HoldenHalucha/office-hours-beacon/hardware/OHBeacon/S2B-ZR-SM4A-TF.step

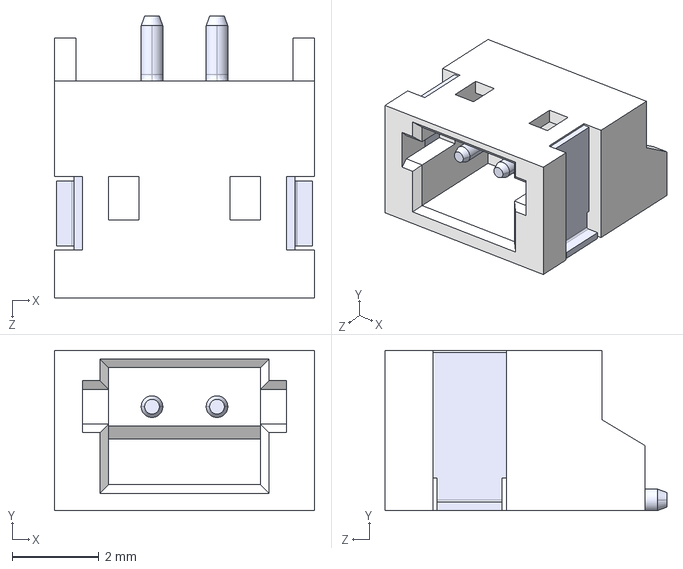
[picture p1: CAD file, 2025-11-12]
hardware/OHBeacon/S2B-ZR-SM4A-TF.step
6.00 x 3.70 x 6.50 mm
