HoldenHalucha/office-hours-beacon/power_usage_data/being_helped/power_profiler_screenshot.jpg

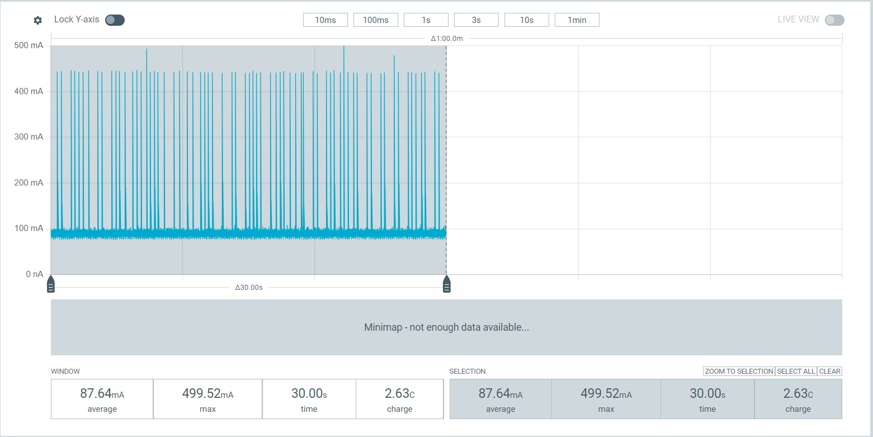
power_usage_data/being_helped/power_profiler_screenshot.jpg
