HoldenHalucha/office-hours-beacon/power_usage_data/not_on_queue/power_profiler_screenshot.jpg

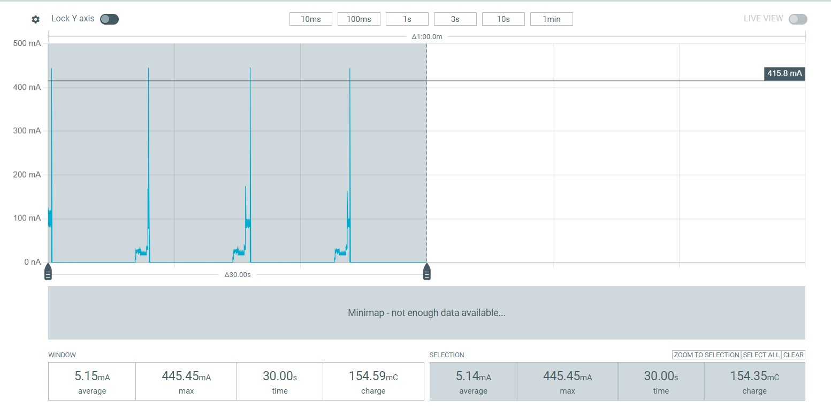
power_usage_data/not_on_queue/power_profiler_screenshot.jpg
