HoldenHalucha/office-hours-beacon/power_usage_data/pos1/power_profiler_screenshot.jpg

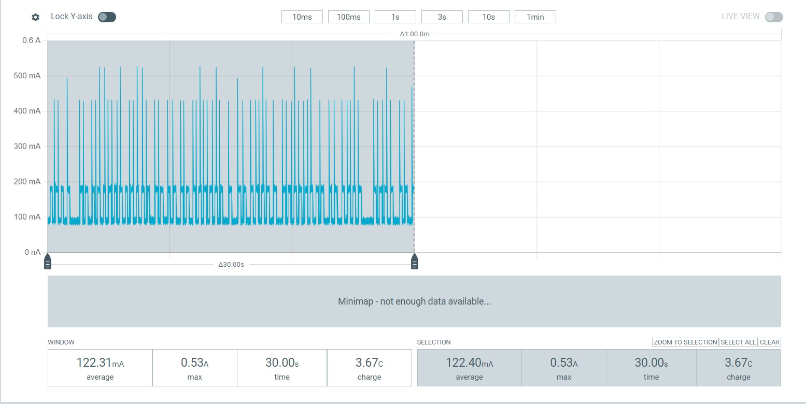
power_usage_data/pos1/power_profiler_screenshot.jpg
