HoldenHalucha/office-hours-beacon/(list of files, drawings)

Other design files:
PowerPCB.PrjPcb
PowerPCB.SchDoc
