HoldenHalucha/office-hours-beacon/hardware/OHBeacon/OHBeacon.kicad_pcb

## KiCad design hardware/OHBeacon/OHBeacon.kicad_pcb (2025-11-14)

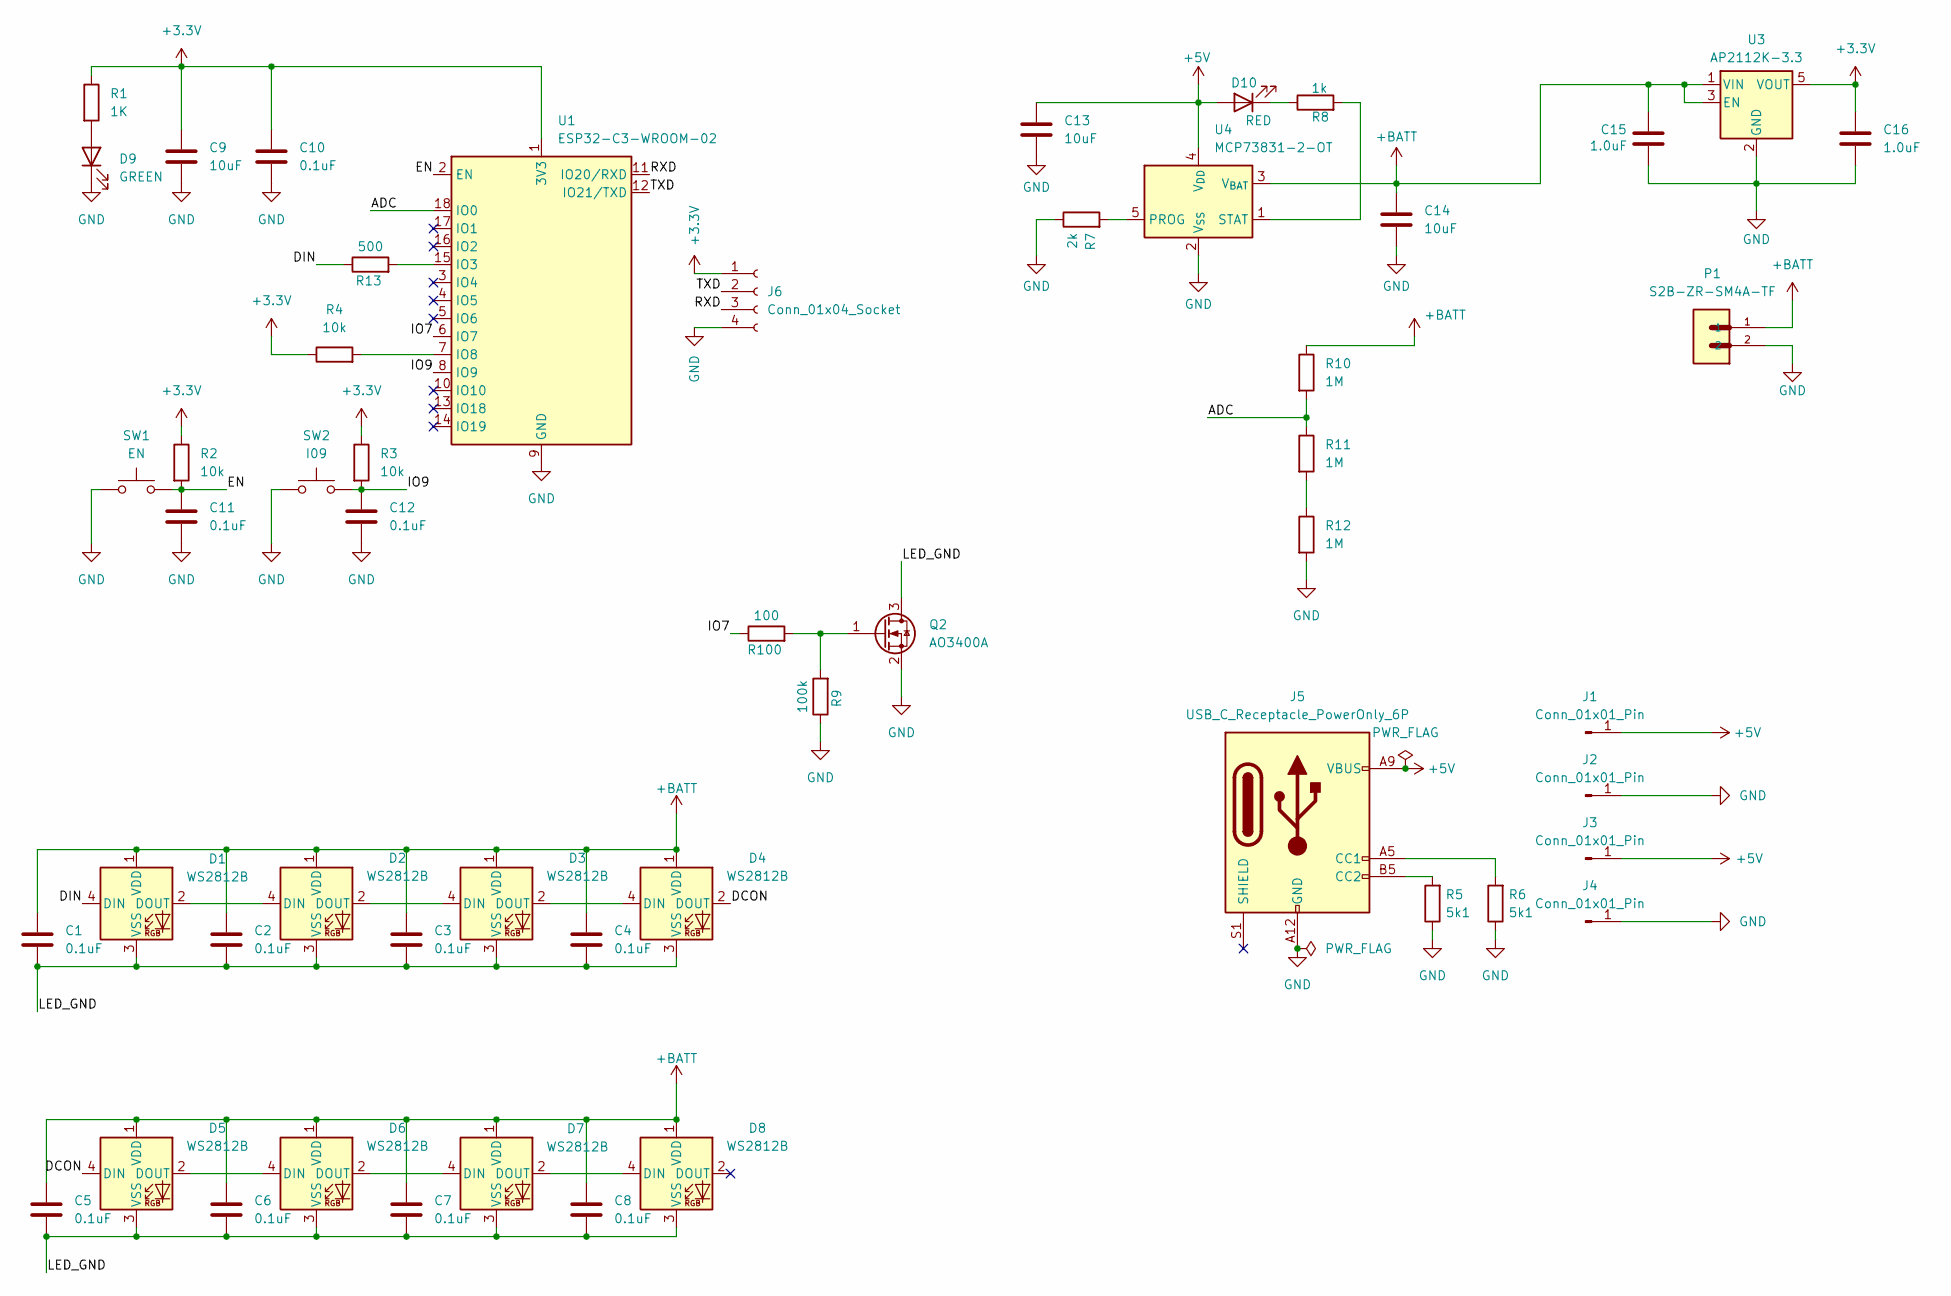
[picture p5: schematic OHBeacon.kicad_sch]

Parts:
C1, C2, C3, C4, C5, C6, C7, C8, C10, C11, C12: 0.1uF; C_0805_2012Metric_Pad1.18x1.45mm_HandSolder
C9, C13, C14: 10uF; C_0805_2012Metric_Pad1.18x1.45mm_HandSolder
C15, C16: 1.0uF; C_0805_2012Metric_Pad1.18x1.45mm_HandSolder
D1, D2, D3, D4, D5, D6, D7, D8: WS2812B; LED_WS2812B_PLCC4_5.0x5.0mm_P3.2mm
D9: GREEN; LED_0805_2012Metric_Pad1.15x1.40mm_HandSolder
D10: RED; LED_0805_2012Metric_Pad1.15x1.40mm_HandSolder
J1, J2, J3, J4: Conn_01x01_Pin; SolderWire-1sqmm_1x01_D1.4mm_OD3.9mm
J5: USB_C_Receptacle_PowerOnly_6P; USB_C_Receptacle_GCT_USB4135-GF-A_6P_TopMnt_Horizontal
J6: Conn_01x04_Socket; PinHeader_1x04_P2.54mm_Vertical
P1: S2B-ZR-SM4A-TF; JST_S2B-ZR-SM4A-TF
Q2: AO3400A; SOT-23
R1: 1K; R_0805_2012Metric_Pad1.20x1.40mm_HandSolder
R2, R3, R4: 10k; R_0805_2012Metric_Pad1.20x1.40mm_HandSolder
R5, R6: 5k1; R_0805_2012Metric_Pad1.20x1.40mm_HandSolder
R7: 2k; R_0805_2012Metric_Pad1.20x1.40mm_HandSolder
R8: 1k; R_0805_2012Metric_Pad1.20x1.40mm_HandSolder
R9: 100k; R_0805_2012Metric_Pad1.20x1.40mm_HandSolder
R10, R11, R12: 1M; R_0805_2012Metric_Pad1.20x1.40mm_HandSolder
R13: 500; R_0805_2012Metric_Pad1.20x1.40mm_HandSolder
R100: 100; R_0805_2012Metric_Pad1.20x1.40mm_HandSolder
SW1: EN; SW_PUSH_6mm
SW2: I09; SW_PUSH_6mm
U1: ESP32-C3-WROOM-02
U3: AP2112K-3.3; SOT-23-5
U4: MCP73831-2-OT; SOT-23-5

Connections:
+3.3V: C9.1, C10.1, C16.1, J6.1, R1.1, R2.1, R3.1, R4.1, U1.1 (3V3), U3.5 (VOUT)
+5V: C13.1, D10.2 (A), J1.1, J3.1, J5.A9 (VBUS), J5.B9 (VBUS), U4.4 (V_{DD})
+BATT: C1.1, C2.1, C3.1, C4.1, C5.1, C6.1, C7.1, C8.1, C14.1, C15.1, D1.1 (VDD), D2.1 (VDD), D3.1 (VDD), D4.1 (VDD), D5.1 (VDD), D6.1 (VDD), D7.1 (VDD), D8.1 (VDD), P1.1, R10.1, U3.1 (VIN), U3.3 (EN), U4.3 (V_{BAT})
/ADC: R10.2, R11.1, U1.18 (IO0)
/DCON: D4.2 (DOUT), D5.4 (DIN)
/DIN: D1.4 (DIN), R13.1
/EN: C11.1, R2.2, SW1.2, U1.2 (EN)
/IO7: R100.1, U1.6 (IO7)
/IO9: C12.1, R3.2, SW2.2, U1.8 (IO9)
/LED_GND: C1.2, C2.2, C3.2, C4.2, C5.2, C6.2, C7.2, C8.2, D1.3 (VSS), D2.3 (VSS), D3.3 (VSS), D4.3 (VSS), D5.3 (VSS), D6.3 (VSS), D7.3 (VSS), D8.3 (VSS), Q2.3 (D)
/RXD: J6.3, U1.11 (IO20/RXD)
/TXD: J6.2, U1.12 (IO21/TXD)
GND: C9.2, C10.2, C11.2, C12.2, C13.2, C14.2, C15.2, C16.2, D9.1 (K), J2.1, J4.1, J5.A12 (GND), J5.B12 (GND), J6.4, P1.2, Q2.2 (S), R5.1, R6.1, R7.1, R9.1, R12.2, SW1.1, SW2.1, U1.9 (GND), U1.19 (GND), U3.2 (GND), U4.2 (V_{SS})
unnamed: D1.2 (DOUT), D2.4 (DIN)
unnamed: D2.2 (DOUT), D3.4 (DIN)
unnamed: D3.2 (DOUT), D4.4 (DIN)
unnamed: D5.2 (DOUT), D6.4 (DIN)
unnamed: D6.2 (DOUT), D7.4 (DIN)
unnamed: D7.2 (DOUT), D8.4 (DIN)
unnamed: D9.2 (A), R1.2
unnamed: D10.1 (K), R8.1
unnamed: J5.A5 (CC1), R6.2
unnamed: J5.B5 (CC2), R5.2
unnamed: Q2.1 (G), R9.2, R100.2
unnamed: R11.2, R12.1
unnamed: R13.2, U1.15 (IO3)
unnamed: R4.2, U1.7 (IO8)
unnamed: R7.2, U4.5 (PROG)
unnamed: R8.2, U4.1 (STAT)

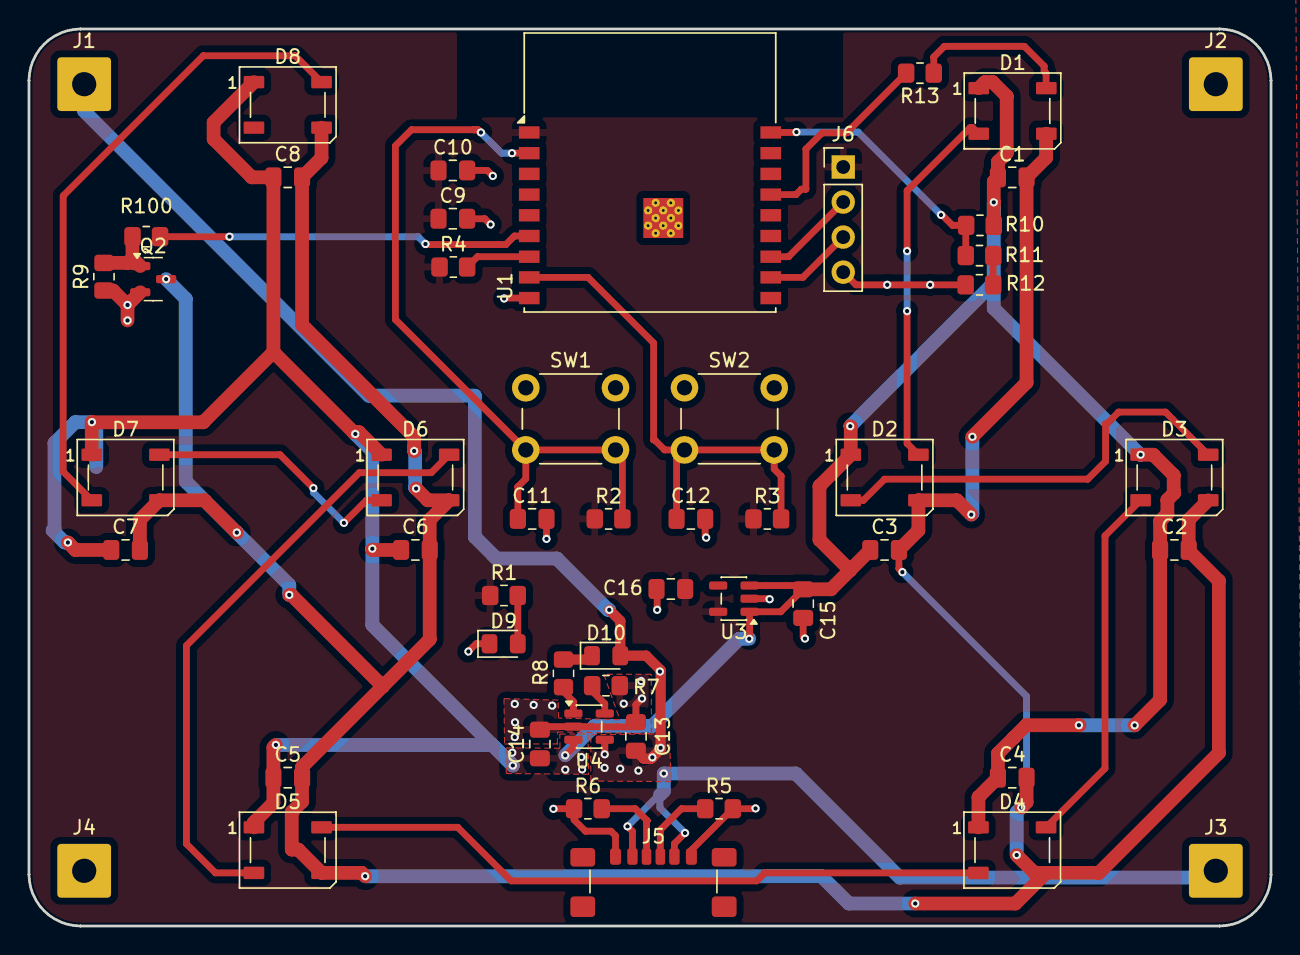
[picture p6: board OHBeacon.kicad_pcb from above]

Board: 2 copper layers, 90.0 x 65.0 mm, 53 parts (1 on the bottom side), 29 nets.
