HoldenHalucha/office-hours-beacon/hardware/raspberryPiHat/RaspberryPiHat.kicad_pcb

## KiCad design hardware/raspberryPiHat/RaspberryPiHat.kicad_pcb (2025-10-27)

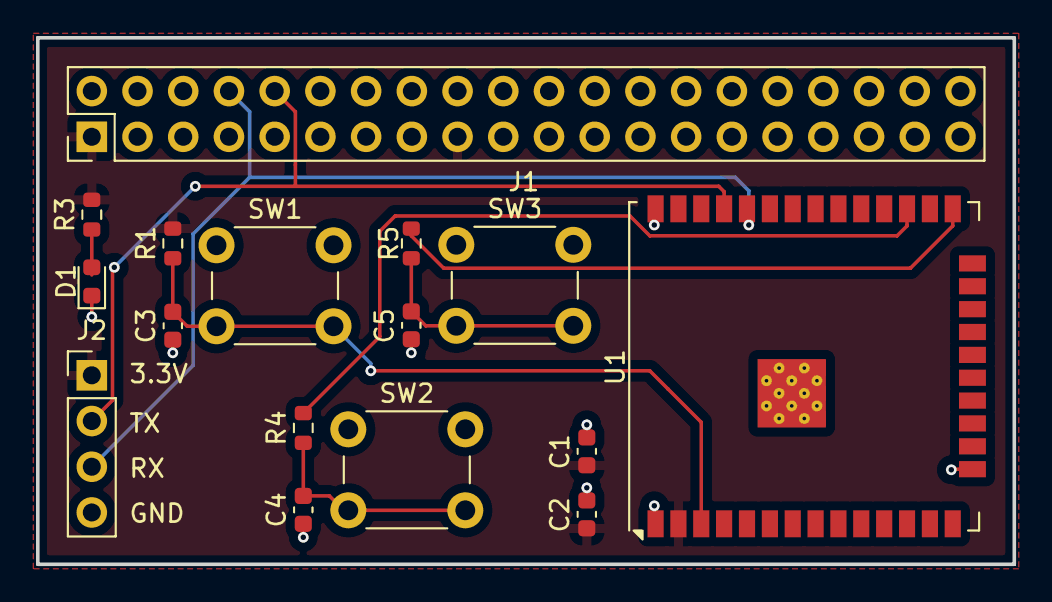
[picture p7: board RaspberryPiHat.kicad_pcb from above]

Board: 2 copper layers, 54.2 x 29.2 mm, 16 parts (0 on the bottom side), 10 nets.

Parts:
C1: 22uF; C_0603_1608Metric
C2, C3, C4, C5: 0.1uF; C_0603_1608Metric
D1: LED; LED_0603_1608Metric
J1: Raspberry_Pi_2_3; PinHeader_2x20_P2.54mm_Vertical
J2: Conn_01x04_Socket; PinHeader_1x04_P2.54mm_Vertical
R1, R4, R5: 10k; R_0603_1608Metric
R3: 150; R_0603_1608Metric
SW1, SW2, SW3: SW_Push; SW_PUSH_6mm
U1: ESP32-WROOM-32U

Connections:
+3.3V: C1.1, C2.1, J1.1 (3V3), J1.17 (3V3), J2.1, R1.1, R3.1, U1.2 (VDD)
/IO0: R5.1, U1.25 (IO0)
/MODE: R4.1, U1.27 (IO16)
/RXD0: J1.8 (GPIO14/TXD), J2.3, U1.34 (RXD0/IO3)
/TXD0: J1.10 (GPIO15/RXD), J2.2, U1.35 (TXD0/IO1)
GND: C1.2, C2.2, C3.2, C4.2, C5.2, D1.1 (K), J1.6 (GND), J1.9 (GND), J1.14 (GND), J1.20 (GND), J1.25 (GND), J1.30 (GND), J1.34 (GND), J1.39 (GND), J2.4, SW1.1, SW2.1, SW3.1, U1.1 (GND), U1.15 (GND), U1.38 (GND), U1.39 (GND)
unnamed: C4.1, R4.2, SW2.2
unnamed: C5.1, R5.2, SW3.2
unnamed: D1.2 (A), R3.2
unnamed: C3.1, R1.2, SW1.2, U1.3 (EN)
