HoldenHalucha/office-hours-beacon/queueFetcher/main.py

#!/usr/bin/env python3
"""
selenium_fetch.py
Use Selenium to sign into the site (interactive or automated),
export cookies, then fetch the JSON and save it.
"""

import os
import time
import json
from fetcher import Fetcher
import serial

OUT_DIR = "./outstanding_json"
BASE_STATION_ID = "A"


# Absolute path to cookies file
COOKIES_FILE = "/home/user473/Documents/project/office-hours-beacon/queueFetcher/oh_cookies.json"

os.makedirs(OUT_DIR, exist_ok=True)

# Configure the serial port and baud rate
ser = serial.Serial(
    port='/dev/serial0',  # or '/dev/ttyS0' depending on your Pi model and OS
    baudrate=9600,
    timeout=1
)



if __name__ == "__main__":

    fetcher_configs = {
        'max_course': 2,
        'course_polling_interval_seconds': 2,
        'course_thread_expiration_seconds': 10,
        'active_course_scan_interval_seconds': 5
    }

    fetcher = Fetcher(BASE_STATION_ID, COOKIES_FILE, configs=fetcher_configs)

    # Precomputed valid course IDs. This list would change if new courses are added to OH queue.
    valid_course_list = [808, 815, 816, 820, 823, 825, 826, 827, 829, 830, 833, 834, 839, 850, 856, 864, 866, 868, 869, 877, 878, 880, 881, 882, 883, 884, 887, 889, 890, 893, 894, 895, 896, 897, 898, 899, 900, 901, 902, 904, 905, 906, 907, 908, 909, 910, 911, 913, 916, 917, 918, 919]
    fetcher.valid_course_list = valid_course_list

    fetcher.start_course_thread_manager(verbose=True)

    try:
        while True:
            time.sleep(2)
            events = fetcher.get_serial_events()

            for event in events:
                message = f"S{event['beacon_id']}%{event['queue_position']}%{event['course_color']}Z"
                print(f"Sending serial message: {message}")
                ser.write(message.encode('ascii'))
                time.sleep(0.1)  # brief pause between messages
             

    except KeyboardInterrupt:
        print("Stopping fetcher...")
        fetcher.running = False
