HoldenHalucha/office-hours-beacon/(commit log)

2025-09-25 Added anither fetch function
    The added fetch_and_print_json() function continuously fetch and print JSON to console.
2025-10-02 raspberry pi hat pcb rev 1
    [RaspberryPiHat.kicad_pcb, RaspberryPiHat.kicad_sch]
2025-10-11 first commit for OH student beacon
    [LED_strip.kicad_sch, OHBeacon.kicad_pcb, OHBeacon.kicad_sch, power_input.kicad_sch, untitled.kicad_sch]
2025-10-11 oh student beacon pcb first commit
2025-10-22 Added "Fetch" class for better encapsulation; Added thread manager to Fetch class
2025-10-23 esp32c3 low power experimentation with ESP-IDF
2025-10-23 new sch
    [OHBeacon.kicad_pcb, OHBeacon.kicad_sch, power_input.kicad_sch]
2025-10-25 Some small changes to receiver code for power saving experimentation.
2025-10-26 prelim beacon pcb
    [OHBeacon.kicad_pcb, OHBeacon.kicad_sch]
2025-10-26 Changed some stuff in the schematic :)
    [OHBeacon.kicad_pcb, OHBeacon.kicad_sch]
2025-10-27 updated beacon
    [OHBeacon.kicad_pcb]
2025-10-27 updated rpi
    [RaspberryPiHat.kicad_pcb, RaspberryPiHat.kicad_sch]
2025-10-28 okay it's fine for prod ig
    [OHBeacon.kicad_pcb]
2025-10-28 production folders for both PCBs
    [bom.csv, designators.csv, positions.csv]
2025-10-28 Added course color and reworked some course thread interface
    [fetch_test.py, fetcher.py, selenium_fetch.py]
2025-11-03 quick fix for testing
    [esp32_receiver.c, esp32_transmitter.ino]
2025-11-04 fixed the mac address sending stuff
    [esp32_transmitter.ino]
2025-11-06 Reverted main to work with oh.eecs
    This commit makes main branch work with oh.eecs.
    Another branch, eecsoh, works with eecsoh.eecs.
    [fetch_test.py, fetcher.py]
2025-11-12 new oh beacon schematic and early routing
    [OHBeacon.kicad_pcb, OHBeacon.kicad_sch, S2B-ZR-SM4A-TF.step]
2025-11-12 new charging
    [OHBeacon.kicad_pcb, OHBeacon.kicad_sch]
2025-11-12 get james approval
    [OHBeacon.kicad_pcb, OHBeacon.kicad_sch]
2025-11-14 final pcb?
    [OHBeacon.kicad_pcb, OHBeacon.kicad_sch]
2025-11-14 for aryan
    [OHBeacon.kicad_pcb]
2025-11-14 even more final PCB???
    [OHBeacon.kicad_pcb, OHBeacon.kicad_sch]
2025-11-14 BOM and Fabrication stuff
    [bom.csv, designators.csv, positions.csv]
2025-11-15 Update BOM with latest edits
    [bom.csv]
2025-11-15 Add digikey BOM
    [digikey_bom.csv]
2025-11-20 Update esp32_receiver.c
    changes to the receiver code with transmitter-receiver packet format
2025-11-20 simple_arduino_esp-now_to_blast_messages/sketch_oct24a.ino
    changes include arduino code for a transmitter to just spam receivers with test values. I have been using this for testing
2025-11-24 more stuff
    [OHBeacon.kicad_pcb]
2025-11-24 added directory for currently partially complete Android app code
2025-12-02 should be mostly working receiver code + power usage data
